stefanhepp/design-libs/kicad/3dmodels/Custom_Connectors.3dmodels/DIN5_PCB_DELTRON_671-0500.STEP

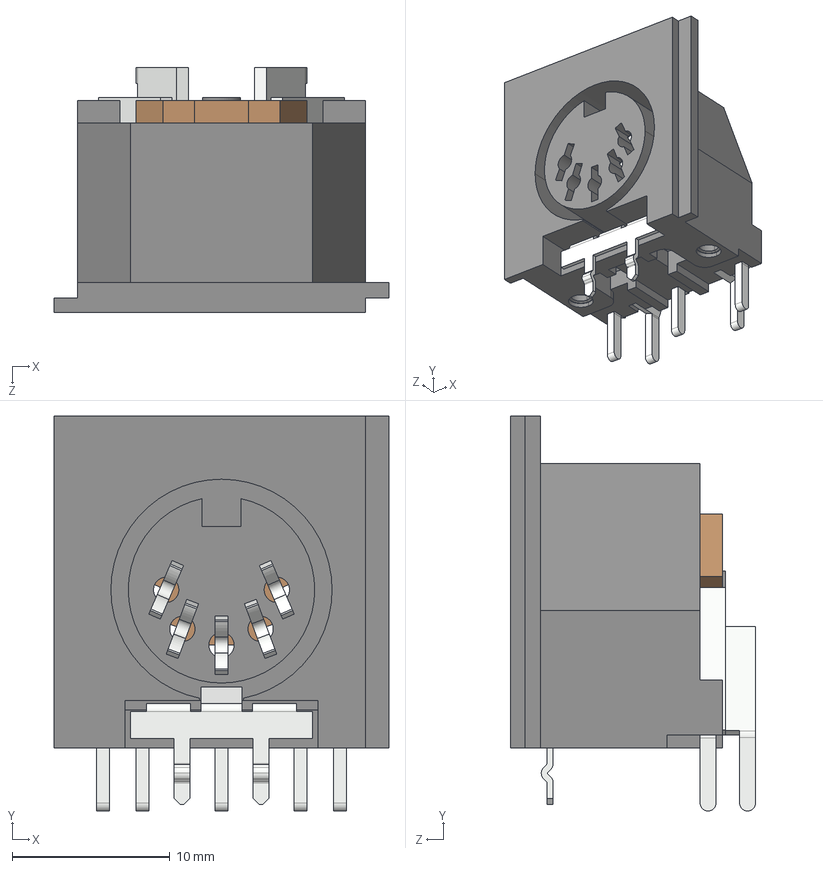
[picture p1: CAD file, 2024-03-05]
kicad/3dmodels/Custom_Connectors.3dmodels/DIN5_PCB_DELTRON_671-0500.STEP
21.2 x 25.0 x 15.5 mm
DIN5_PCB_DELTRON_BODY
DIN5_PCB_DELTRON_PIN2
DIN5_PCB_DELTRON_PIN5
DIN5_PCB_DELTRON_PIN3
DIN5_PCB_DELTRON_PIN4
DIN5_PCB_DELTRON_PIN1
DIN5_PCB_DELTRON_FIX
DIN5_PCB_DELTRON_SHIELD
