stefanhepp/design-libs/boards/SOIC-16-Breakout/SOIC-16-Breakout.kicad_pcb

## KiCad design boards/SOIC-16-Breakout/SOIC-16-Breakout.kicad_pcb (2025-05-26)

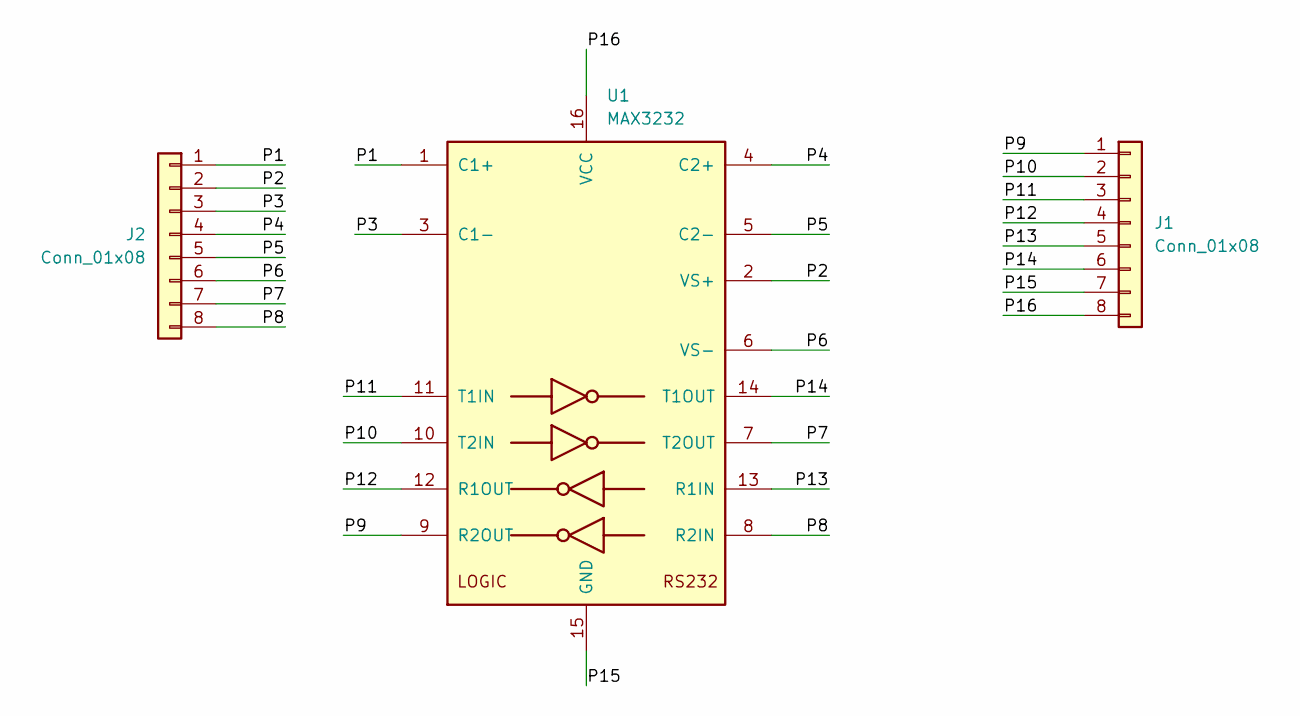
[picture p2: schematic SOIC-16-Breakout.kicad_sch]

Parts:
J1, J2: Conn_01x08; PinHeader_1x08_P2.54mm_Vertical
U1: MAX3232; SOIC-16_3.9x9.9mm_P1.27mm

Connections:
/P1: J2.1, U1.1 (C1+)
/P2: J2.2, U1.2 (VS+)
/P3: J2.3, U1.3 (C1-)
/P4: J2.4, U1.4 (C2+)
/P5: J2.5, U1.5 (C2-)
/P6: J2.6, U1.6 (VS-)
/P7: J2.7, U1.7 (T2OUT)
/P8: J2.8, U1.8 (R2IN)
/P9: J1.1, U1.9 (R2OUT)
/P10: J1.2, U1.10 (T2IN)
/P11: J1.3, U1.11 (T1IN)
/P12: J1.4, U1.12 (R1OUT)
/P13: J1.5, U1.13 (R1IN)
/P14: J1.6, U1.14 (T1OUT)
/P15: J1.7, U1.15 (GND)
/P16: J1.8, U1.16 (VCC)

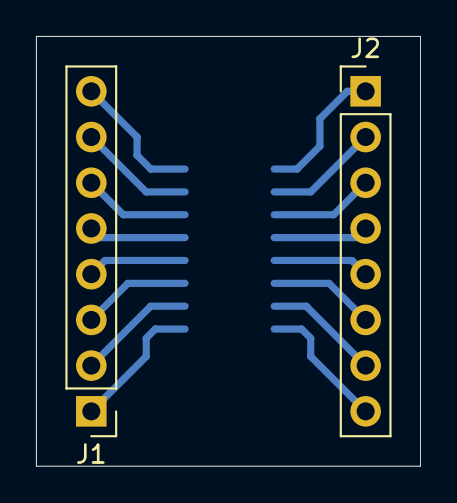
[picture p3: board SOIC-16-Breakout.kicad_pcb from above]

Board: 2 copper layers, 21.3 x 23.9 mm, 3 parts (1 on the bottom side), 16 nets.
