stefanhepp/design-libs/boards/IDC10-Breakout/IDC10-Breakout.kicad_pcb

## KiCad design boards/IDC10-Breakout/IDC10-Breakout.kicad_pcb (2024-09-07)

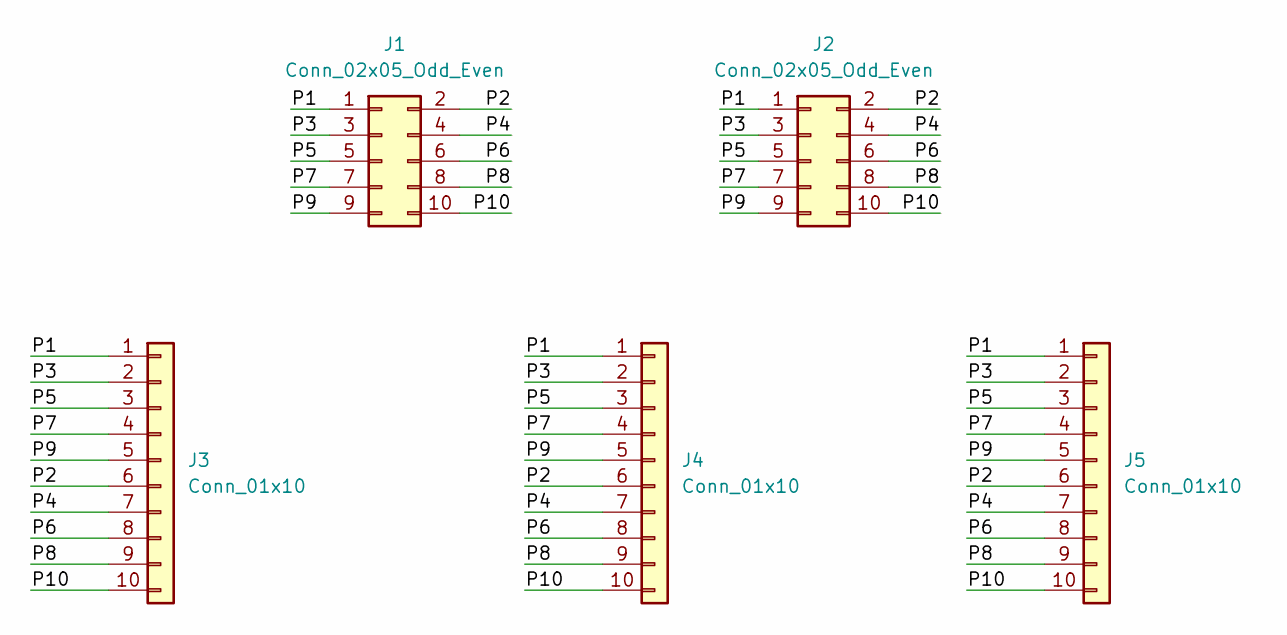
[picture p4: schematic IDC10-Breakout.kicad_sch]

Parts:
J1, J2: Conn_02x05_Odd_Even; IDC-Header_2x05_P2.54mm_Vertical
J3: Conn_01x10; PinHeader_1x10_P2.54mm_Vertical
J4, J5: Conn_01x10; PinSocket_1x10_P2.54mm_Vertical

Connections:
/P1: J1.1, J2.1, J3.1, J4.1, J5.1
/P2: J1.2, J2.2, J3.6, J4.6, J5.6
/P3: J1.3, J2.3, J3.2, J4.2, J5.2
/P4: J1.4, J2.4, J3.7, J4.7, J5.7
/P5: J1.5, J2.5, J3.3, J4.3, J5.3
/P6: J1.6, J2.6, J3.8, J4.8, J5.8
/P7: J1.7, J2.7, J3.4, J4.4, J5.4
/P8: J1.8, J2.8, J3.9, J4.9, J5.9
/P9: J1.9, J2.9, J3.5, J4.5, J5.5
/P10: J1.10, J2.10, J3.10, J4.10, J5.10

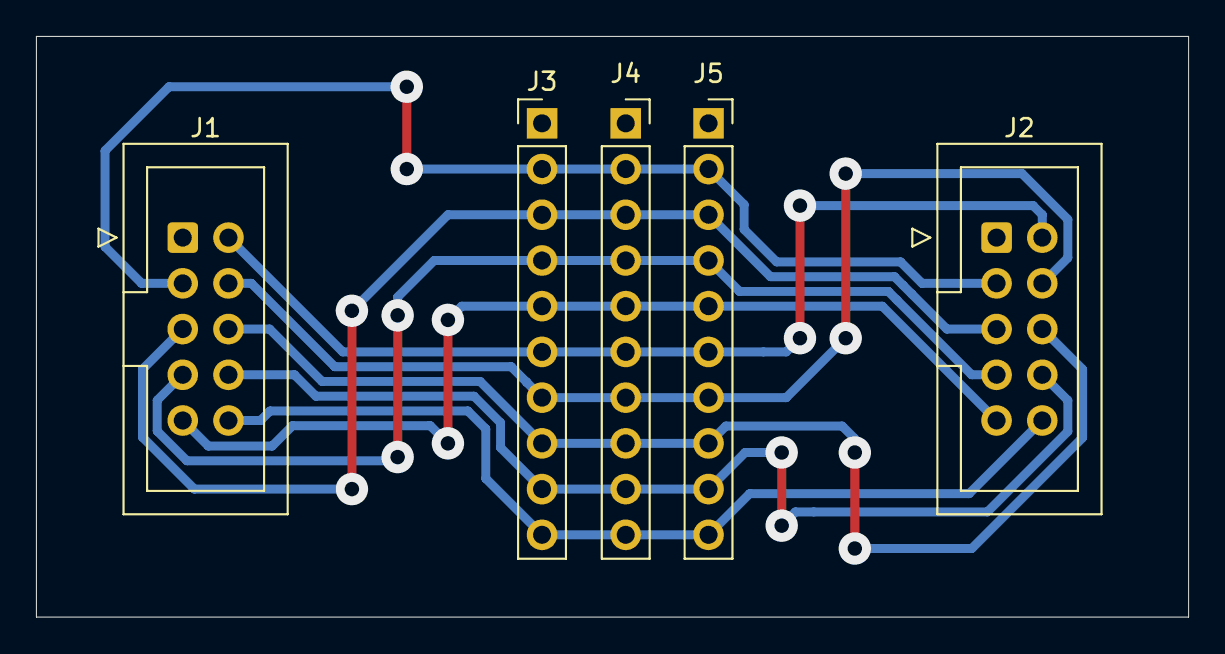
[picture p5: board IDC10-Breakout.kicad_pcb from above]

Board: 2 copper layers, 64.0 x 32.3 mm, 5 parts (0 on the bottom side), 10 nets.
