stefanhepp/design-libs/boards/PCB-Test/PCB-Test.kicad_pcb

## KiCad design boards/PCB-Test/PCB-Test.kicad_pcb (2024-05-01)

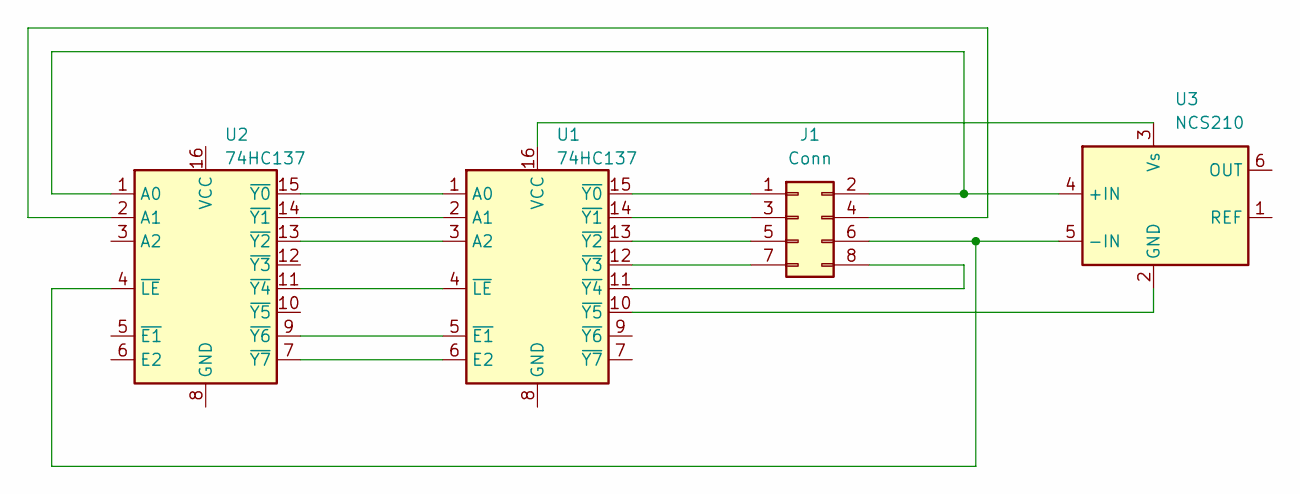
[picture p6: schematic PCB-Test.kicad_sch]

Parts:
J1: Conn; PinSocket_2x04_P2.54mm_Vertical
U1: 74HC137; SOIC-16_3.9x9.9mm_P1.27mm
U2: 74HC137; DIP-16_W7.62mm
U3: NCS210; SOT-363_SC-70-6_Handsoldering

Connections:
unnamed: J1.1, U1.15 (~Y0)
unnamed: J1.2, U2.1 (A0), U3.4 (+IN)
unnamed: J1.3, U1.14 (~Y1)
unnamed: J1.4, U2.2 (A1)
unnamed: J1.5, U1.13 (~Y2)
unnamed: J1.6, U2.4 (~LE), U3.5 (-IN)
unnamed: J1.7, U1.12 (~Y3)
unnamed: J1.8, U1.11 (~Y4)
unnamed: U1.1 (A0), U2.15 (~Y0)
unnamed: U1.2 (A1), U2.14 (~Y1)
unnamed: U1.3 (A2), U2.13 (~Y2)
unnamed: U1.6 (E2), U2.7 (~Y7)
unnamed: U1.16 (VCC), U3.3 (Vs)
unnamed: U1.5 (~E1), U2.9 (~Y6)
unnamed: U1.4 (~LE), U2.11 (~Y4)
unnamed: U1.10 (~Y5), U3.2 (GND)

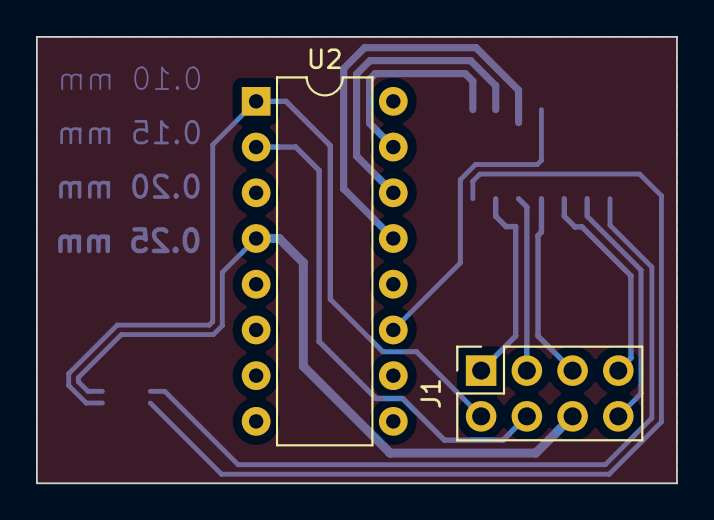
[picture p7: board PCB-Test.kicad_pcb from above]

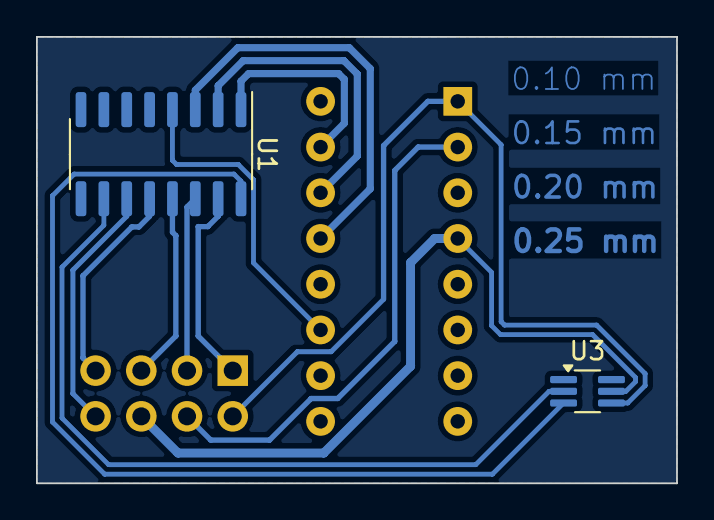
[picture p8: board PCB-Test.kicad_pcb from below]

Board: 2 copper layers, 35.6 x 24.8 mm, 4 parts (2 on the bottom side), 16 nets.
