stefanhepp/design-libs/(commit log)

2023-04-17 Initial commit of test PCB
    [PCB-Test.kicad_pcb, PCB-Test.kicad_sch]
2023-04-18 Added KiCAD template for PCB milling design rules
    [DesignRules-PCBMilling.kicad_pcb, DesignRules-PCBMilling.kicad_sch]
2023-06-24 Added reference to Arduino library
2023-10-21 Ignore KiCAD *.lck files
2024-03-04 Added more compact resistor pack SIL symbol
2024-03-05 Added DIN 5 footprint and model, rearranged lib folders
    [DIN5_PCB_DELTRON_671-0500.STEP]
2024-03-06 Avoid overlap in DIN-5 connector footprint
2024-03-07 Added DCDC Gaptec converter symbol and footprint
2024-03-08 Fixed footprint size of Gaptec DCDC converter
2024-03-11 Added footprint for CR2032 holder
2024-04-13 Update PCB test board with different track sizes
    [PCB-Test.kicad_pcb, PCB-Test.kicad_sch]
2024-04-14 Updated test PCB for milling, remove too small footprint
    [PCB-Test.kicad_pcb, PCB-Test.kicad_sch]
2024-05-01 Added new PCB design rule templates for PCB milling
    [DesignRules-PCBMilling-0.27mm.kicad_pcb, DesignRules-PCBMilling-0.27mm.kicad_sch, DesignRules-PCBMilling-0.32mm.kicad_pcb, DesignRules-PCBMilling-0.32mm.kicad_sch, DesignRules-PCBMilling-0.40mm.kicad_pcb, DesignRules-PCBMilling-0.40mm.kicad_sch, DesignRules-PCBMilling.kicad_pcb, DesignRules-PCBMilling.kicad_sch]
2024-05-05 Added FlatCam tool database, updated 0.4mm PCB template settings
2024-05-18 Updated design rules for 0.32mm PCB routing
2024-06-26 Added small test PCB for tuning milling parameters, updated tools database
    [PCB-Test 0.32mm.kicad_pcb, PCB-Test 0.32mm.kicad_sch]
2024-07-27 Added IDC-10 breakout board
    [IDC10-Breakout.kicad_pcb, IDC10-Breakout.kicad_sch]
2024-08-04 Export gerber using milling origin
    [IDC10-Breakout.kicad_pcb]
2024-09-07 Updated FlatCam tools database, IDC10 breakout board
2024-09-07 Fabrication output for IDC10 board
    [IDC10-Breakout.kicad_pcb]
2024-10-20 Added audio connector footprint with pin names mapped to KiCAD symbols, and audio breakout board
    [AudioJack-Breakout.kicad_pcb, AudioJack-Breakout.kicad_sch]
2025-04-10 Added initial version of ESP32 module footprints
2025-04-22 Footprint for ESP32 30pin devkit module
2025-04-23 Added TO-92 footprints with larger annuals for milling
2025-05-08 Added TO-92 footprints with wider spacing for milling
2025-05-23 Added SO-16 adapter board
    [SOIC-16-Breakout.kicad_pcb, SOIC-16-Breakout.kicad_sch]
2025-05-26 Setup gerber output for SOIC-16 adapter
    [SOIC-16-Breakout.kicad_pcb]
